LokiMetaSmith/MR1/.jules/memory.md

## Archived: 2026-10-31

- `scripts/render_flythrough.py` renders a three-shot video sequence using PyVista and `simulations/nanopore_electrokinetics.py`: Shot 1 animates a reverse explosion assembly of system and PCB parts; Shot 2 zooms into a 500 µm silicon die, 10x10 µm thinned window, and 100 nm pore; Shot 3 showcases multi-scale pores (100 µm down to 1 nm) with simulated ionic current HUD overlays. Supports `--test` and `--frames` CLI arguments.
- In KiCad 8 footprint S-expression syntax (`.kicad_mod`), `zone_connect` tokens inside pad definitions are invalid syntax. Footprints generated by `scripts/generate_footprint.py` synchronize across `Amplifier/footprints.pretty/`, `Amplifier/footprints/`, and `Interposer/footprints.pretty/`.
- Full suite exports via `scripts/export_all.js` historically fail to generate 2D DXF files (like `Plate_1_Base_DXF.dxf` and `Gasket_Main_DXF.dxf`) due to a known 'Mixing 2D and 3D objects' warning around line 21 in `mr1_nanopore_reader.scad`. This is expected behavior and not a regression.
- In `build123d` (`src/housing.py`), `Housing_Pump_Lid` features a continuous solid top face (without a center pass-through hole) and an attached bottom indexing lip positioned to overlap slightly into the main lid body, producing a single contiguous solid.
- Standardized 4-electrode sensing terminology across the codebase and documentation is: `WS_CIS` (Working Sense), `WE_POS` (Working Electrode Positive), `RE_TRANS` (Reference Electrode Trans), `CE_GNDA` (Counter Electrode Ground), and `GUARD`.
- The canonical project name is 'MR1'. Legacy terms like 'Sentinel', 'Daemon Pore', or 'daemon-pore' have been universally replaced. Specific casing conventions apply: UPPER_CASE or PascalCase contexts use 'MR1', while snake_case, kebab-case, camelCase, and filenames use 'mr1'.
- KiCad BOM and Gerber export tests (e.g., `test_interposer_bom_completeness`, `test_interposer_gerber_exports`) are intentionally skipped and tracked in `TODO.md` pending robust CI support for the `kicad-cli` toolchain.
- In the MR1 system architecture, high-speed ADC U13 (AD40xx) is located on the Cartridge Amplifier board, while dual DAC U9 (MCP4822) resides on the MR1 Main Controller Board.
- Optional topology optimization and simulation extras (`torch`, `dl4to`) are specified in `pyproject.toml` under `[project.optional-dependencies] simulation`.
- `simulations/torque_cap_topology_optimization.py` provides the topology optimization bridge for `Torque_Cap_Outer` flexure arms using build123d CAD design domain definitions and `dl4to`, featuring CLI options and analytical fallback logic when PyTorch/dl4to are omitted.
- `install.sh` checks for PlatformIO in `.venv`, system `PATH`, and via `python -m platformio`, automatically installing `platformio` into `.venv` via `pip` if missing. `scripts/export_manager.py` prioritizes finding `pio` inside `.venv` before checking system `PATH`.
- The `Torque_Cap_Outer` 6 cantilever flexure arms (tongs) use a compliant 1.8 mm PETG living hinge thickness with 2.5 mm root fillets and 1.5 mm radius pawl tips ($R = 38.7\text{ mm}$), tuned to deliver a slip torque limit of $\approx 0.5\text{ N}\cdot\text{m}$ ($F_{\text{clamp}} \approx 33.3\text{ N}$) to compress the 12 pogo pins (~9.6 N total load) and seat the silicone gasket without over-tightening.
- The repository includes a formal verification suite in `tests/test_formal_proofs.py` using `z3-solver` and `hypothesis` to prove SMT theorems and property-based invariants across firmware/protocol logic, physics/analog front-end, geometric/CAD layout, microfluidics, electrokinetics, pump ESTOP safety logic, DAQ stream framing, firmware state machine, and electrical harness pin mapping, integrated directly into `run_tests.py`.
- In `imageio.mimsave`, setting `macro_block_size=1` prevents image width/height padding warnings when exporting 1080p VP9 WebM videos.
- Readout route selection on the MR1 Nanopore Reader uses `PIN_ROUTE_SEL` (GPIO2) to control the `U17` SPDT switch between Route 1 (10 GΩ gain, LMP7721, `ROUTE_SEL` LOW) and Route 2 (100 kΩ gain, OPA2192, `ROUTE_SEL` HIGH). Firmware protocol uses `STATUS_ROUTE2_ACTIVE = (1 << 7)`, commands `SET:ROUTE:<1|2>` and `GET:ROUTE`, `/api/route` HTTP API, and `daq_client.py` auto-adjusts transimpedance gain dynamically from stream telemetry.
- Execute environment setup using `bash ./setup_env.sh` rather than direct execution (`./setup_env.sh`) to prevent permission denied errors.
- The repository includes KiCad projects such as 'Amplifier' and 'MR1'. Auto-generated `.history` directories within these project folders are appropriately ignored via `.gitignore` and must never be tracked as git submodules.
- On the MR1 Interposer, microfluidic Cis flow connects H1 to H2 and Trans flow connects H3 to H4. Standard interposer electrode footprints use `Electrode` and `Electrode_Guard`, while pogo pin target landings default to `PogoPin_Target_Landing_1Pin` (or `PogoPin_Target_Landing_1Pin_Guarded` for High-Z/guard nets).
- In `Interposer/Interposer.kicad_sch` and `Interposer/Interposer.kicad_pcb`, mounting/fluid holes `H1`, `H2`, `H3`, `H4` are defined using `Mechanical:MountingHole` symbols with `Value: FluidHole` and `Footprint: MountingHole:MountingHole_2.1mm`.
- The MR1 Main Controller Board PCB is a 4-layer FR4 design with split ground planes (GNDA and GND on Layer 2) and split power planes (VDDA/VSSA and 3V3/VBUS on Layer 3), driven by an ESP32-S3-MINI-1U microcontroller.
- When calling shape-generating helper functions inside an active `BuildPart` context, encapsulate helper shape construction inside `with BuildPart(mode=Mode.PRIVATE)` to prevent intermediate untapered or raw geometries from automatically merging into the parent context.
- The distributed 2 x 6 pogo pin layout divides pins into Bank B (Cis / High-Z Sensing, Y > 0) and Bank A (Trans / Excitation & Fluid Drain, Y < 0) across X = -18 mm to +18 mm to distribute mechanical spring loads across the 55 mm x 52 mm hexagonal envelope and isolate high-amplitude excitation drive from high-Z sensing nodes.
- In `src/common.py`, `generate_helical_thread` creates trapezoidal helical threads with lead-in/lead-out tapers and radial core shaft overlap (default 0.3mm) to ensure valid, single-solid boolean unions for external and internal threads.
- The Interposer KiCad PCB layout (`Interposer/Interposer.kicad_pcb`) is dynamically generated by `scripts/build_interposer_kicad.py`. Updating interposer board features or 12-pin target layouts requires updating `scripts/build_interposer_kicad.py` and running `python3 scripts/build_interposer_kicad.py --write` to regenerate the PCB file.
- The distributed pogo pin interface maps 12 nets across Cis (Bank B) and Trans (Bank A): P1: `GNDA_SHLD`, P2: `WS_CIS_WIDE` (guarded), P3: `GUARD_WIDE`, P4: `GUARD_CIS_A`, P5: `WS_CIS` (guarded), P6: `GUARD_CIS_B`, P7: `CE_GNDA`, P8: `RE_TRANS`, P9: `>PORE_AMP`, P10: `GNDA`, P11: `WEEP_SENSE`, P12: `GNDA_WEEP`.
- In `build123d`, `Housing_Case_Reader` has a total base case height of 15.0mm (`READER_CASE_H`), cleanly enclosing the 5mm PCB standoffs and USB-C cutout within its internal walls.
- Python test suites in `tests/` (such as `tests/test_geometry.py`) require running with `PYTHONPATH=. python3 tests/test_geometry.py` or `PYTHONPATH=. python3 -m unittest discover tests`.
- `scripts/export_manager.py` supports `--release-tag <version>` (and `make release-gerbers VERSION=<version>`), which generates dynamic PCB deliverables and bundles board Gerbers, BOMs, schematics, and a `SHA256SUMS.txt` manifest into `releases/<version>/` while providing the git tag command for hardware releases.
- A Python virtual environment wrapper script is located at `scripts/run_python.sh`. It auto-detects the repository root and `.venv`, auto-runs `setup_env.sh` if `.venv` is missing, sets `PYTHONPATH` to the repository root, and passes all arguments to the venv Python binary (e.g., `./scripts/run_python.sh scripts/generate_footprint.py --help` or `cd scripts && ./run_python.sh generate_footprint.py --help`).
- In `build123d`, `Housing_Lid_Reader` uses an external helical thread with major diameter 74.5mm, thread depth 4.75mm (`THREAD_DEPTH`), and pitch 8.0mm (`CAP_THREAD_PITCH`). Its mating part `Torque_Cap_Inner` uses a matching 4.75mm thread depth with a 75.5mm internal bore diameter for 3D printing tolerance.
- The project uses `ocp_viewer` as a standalone WebSocket 3D CAD canvas server listening on port 3939. `install.sh --viewer` checks if port 3939 is already active before detaching `python -m ocp_viewer` via `nohup` with stdout/stderr redirected to `/dev/null`, then automatically executes `src/assembly.py` to populate the MR1 assembly model. `src/main.py` supports a `--viewer` (or `--show`) CLI flag to stream exported CAD parts directly to `ocp_viewer`.
- In `src/assembly.py`, `get_tubing_routes()` defines the 5 microfluidic tubing spline routes (`TUBE_PUMP`, `TUBE_FEED`, `TUBE_TRANS_LINE`, `TUBE_WASTE_1`, `TUBE_WASTE_2`), which route through Luer bulkhead panel mount bore holes and hollow housing space into the hexagonal cartridge stack ports without cutting away or overlapping solid CAD model geometries.
- In the build123d python port, `Housing_Lid_Reader` features horizontal side fluid ports at `Z = -13.0`, vertical fluid pass-through holes of `D=13mm`, and explicitly includes `Weep_Duct_Holes` subtracted from the ceiling so the weep drops penetrate into the internal hollow hexagonal cavity.
- The Amplifier board (`Amplifier.kicad_sch`, `Amplifier.kicad_pcb`) uses a single-sided component assembly with all discrete components, ICs, and Mill-Max SMT pogo pins (`P1`–`P12`) placed on `F.Cu` (top layer). Multi-pin header banks are deprecated in favor of 12 discrete 1-pin components (`PogoPin_MillMax_SMT_1Pin` and `PogoPin_MillMax_SMT_1Pin_Guarded`). The interposer mating pad `J_PAD1` uses `PogoPin_Target_Landing_1Pin_Guarded` on `F.Cu` with Pin 1 (`>PORE_AMP`) and Pin 2 (`GUARD`).
- All project files have been changed to be capitalized. When referencing KiCad files (like `.kicad_pcb` or `.kicad_sch`) within scripts or tools, ensure the filenames use capitalized project names (e.g., `Amplifier.kicad_pcb`, `MR1.kicad_pcb`).
- The default 1 Gohm TIA feedback configuration produces a ±2.048 nA dynamic range suited for sub-5 nm apertures; scaling to larger apertures (5-100 nm) or higher currents requires reducing transmembrane bias voltage or adjusting the feedback resistor value (100 Mohm, 10 Mohm, or 1 Mohm).
- When constructing sub-features in `build123d` inside a `with Locations(...)` block, avoid calling `insert()` or `add()` on shapes constructed within that same active context, as active locations will be applied twice. Pre-construct shapes at the origin before placing them with `Locations`.
- Run project tests within the virtual environment using `PYTHONPATH=. /app/.venv/bin/python3 -m unittest discover tests`.
- In `mr1_nanopore_reader.scad`, the STL exports for `Gasket_Mold_Top_STL` and `Gasket_Mold_Bottom_STL` conditionally output the flattened `Nanopore_Wafer_Mold_Right` and `Nanopore_Wafer_Mold_Left` halves when `Use_Nanopore_Wafer_Gasket = true`, replacing the legacy single-piece `Gasket_Mold_3D` export.
- The Reader Module houses the main reader PCB (PCB_Main_Reader) at the bottom of the base case (Housing_Case_Reader) on 5mm standoffs. A single parameterized USB-C port cutout is located on the back wall of the base case at X = USB_OFFSET_X (-15.0). The top lid (Housing_Lid_Reader) is 35mm thick to provide vertical clearance for internal fluid tubing.
- In `Housing_Case_Reader`, the four truncated-sphere feet dimples on the bottom exterior surface are positioned at `(±(BASE_W/2 - FEET_INSET), ±(BASE_L/2 - FEET_INSET))` = `(±42.5mm, ±42.5mm)` at `Z = -READER_CASE_H/2`, matching the corresponding top dimple recesses on `Housing_Pump_Lid` for stacking.
- The 200 nm wide-pore channel (Path 2) utilizes an OPA192/LTC6268 wideband TIA stage ($R_{f2} = 100\text{ k}\Omega$, $C_{f2} = 15\text{ pF}$) connected to Pin 10 (`WS_CIS_WIDE`) with a unity-gain Stage 2 buffer, preventing rail saturation under 200 nA - 2 µA open-pore baseline currents while maintaining ~106 kHz analog bandwidth.
- The project is dedicated to the public domain under the Creative Commons CC0 1.0 Universal license (`CC0-1.0`). Source files (including `.py`, `.scad`, `.cpp`, `.h`, `.sh`) feature the attribution header 'Created by Lawrence R. Kincheloe III / Molecular Reality Corp (2026).' (or specific author attribution such as Jade O'Neill) and 'SPDX-License-Identifier: CC0-1.0'.
- In `build123d` Python scripts, the `add()` function is deprecated; use `insert()` instead for combining parts in a build context.
- Photorealistic PyVista renders use 1080p resolution, SSAA anti-aliasing, a deep studio background (#0E1114 to #1B2026), and multi-point PBR studio lighting (key, fill, rim, overhead lights with 'scenelight').
- The footprint generation script is located at `scripts/generate_footprint.py`. It generates discrete 6-pin/12-pin headers, 4 single-pin modular footprint variants (`PogoPin_MillMax_SMT_1Pin`, `PogoPin_MillMax_SMT_1Pin_Guarded`, `PogoPin_Target_Landing_1Pin`, `PogoPin_Target_Landing_1Pin_Guarded`), and fluid overlay footprints (`Fluid_Overlay_DRILLS`, `Fluid_Overlay_SILKSCREEN_ONLY`). It supports custom per-pin coordinate mapping (`--pin-coords`) and parsing manually placed pin coordinates from KiCad PCB files (`--read-pcb`). Default output location is `Interposer/footprints.pretty/PogoPin_Target_6Pin_Distributed.kicad_mod`.
- `scripts/websocket_bridge.py` (authored by Jade O'Neill / Molecular Reality Corp (2026)) bridges serial or mock DAQ streaming telemetry from `daq_client.DaqClient` to WebSocket clients, converting raw ADC counts into physical current values in picoamperes (pA) and broadcasting binary frame chunks containing an 8-byte uint64 (`<Q`) microsecond timestamp header followed by float32 sample arrays. It batches 16 USB frames by default (1024 samples per message, 4104 bytes total @ ~97.66 Hz, configurable via `--batch-frames`).
- In `src/cartridge.py`, `Rigid_Backing_Anvil` models a 6.0 mm Delrin or Anodized Aluminum 6061-T6 backing anvil to clamp the 2-layer PTFE interposer against point loads from the 12 pogo pins (~0.8 N per pin, ~9.6 N total load) to prevent viscoelastic cold flow (creep).
- When calculating the volume of boolean intersections in build123d Python tests (e.g., `inter = solid.intersect(probe)`), `inter` often returns a `ShapeList`. Handle this by safely summing the volumes of its constituent parts (e.g., `sum(s.volume for s in inter) if inter is not None else 0.0`).
- For a 1/4 inch (6.00 mm - 6.35 mm) spacer stackup, LCSC part # C5221285 (MPN: YTC1P-6030-01) is used as the SMD pogo pin with a 9.0 mm free length, 7.5 mm working height (1.5 mm stroke), and 2.0 mm diameter base for `PogoPin_MillMax_SMT_1Pin` and `PogoPin_MillMax_SMT_1Pin_Guarded` footprints.
- `Amplifier/Amplifier.kicad_pcb` uses a 2-layer 1.5 mm Rogers PTFE (RO3003 / ZYF255DA) core stackup with solder mask clearance exclusions on F.Mask and B.Mask over the LMP7721 guarded region, a B.Cu GNDA keepout zone beneath the input node, and a solid B.Cu GUARD island mirroring the top input node footprint.
- The coax pogo-pin architecture standardizes all pin footprints on Pad 1 = signal (circular or square) and Pad 2 = concentric outer ring (GUARD, GUARD_WIDE, or GNDA), driven by `src/stack_spec.py` as the single source of truth across CAD, KiCad footprints, and verification tests.
- In `Amplifier.kicad_sch`, SMT pogo pin symbols connect Pin 1 (SIG) to signal lines (`WS_CIS_WIDE` on P2, `WS_CIS` on P5) and Pin 2 (GUARD) to active driven guard rings (`GUARD_WIDE` on P2, `GUARD` on P5).
- One-shot dynamic hardware and PCB rebuild is executed via `make rebuild` (`scripts/rebuild_all.py`), which validates `src/stack_spec.py`, generates KiCad footprint libraries, checks CAD solid alignment, exports deliverables, and runs the 160+ test suite. `make rebuild-check` validates CI compliance without modifying files.
- `src/spacers.py` models the 3D-printed adjustable spacer (height >= 3.0 mm) with component cavity relief, solid Polypropylene (PP) 0.030" shim, and Delrin 0.125"/0.270" blocks to fill margins around inverted amplifier components and prevent pogo wicking.
- `scripts/build_amplifier_kicad.py` and `scripts/build_interposer_kicad.py` provide automated `--check` and `--write` sync for discrete coax pin placements on both PCBs, wired directly into `scripts/rebuild_all.py` Step 4.
- `tests/test_legacy_feature_parity.py` was renamed to `tests/test_cad_features.py` (`TestCADFeatureValidation`) to fully disconnect OpenSCAD terminology while preserving build123d feature assertions.
- Capillary rise physics in `simulations/guard_ring_electrostatics.py` verifies that a hydrophobic PP shim (contact angle $\theta \approx 100^\circ$) produces capillary depression ($\cos\theta < 0$), physically arresting saline wicking along pogo pin shafts.
- `scripts/build_amplifier_kicad.py` supports `--sync-spec` to import manual KiCad PCB pin coordinates and guarding directly into `src/stack_spec.py`. `scripts/rebuild_all.py` (and `make rebuild-check`) safely gates manual PCB modifications against accidental overwrites.
- `scripts/back_propagate_pcb.sh` (`make back-propagate-pcb`) provides an automated 5-step pipeline that propagates manual `Amplifier.kicad_pcb` layout changes to `stack_spec.py`, footprint libraries, mating interposer routes, CAD geometry, and test validation.
- BEFORE making ANY change or running modifying scripts/pipelines, ALWAYS verify and capture a git commit or branch of the current repository state (and/or snapshot hardware files with `scripts/backup_hardware.py`). This allows immediate, clean reversal of any error in scripts, commands, or layout adjustments.
- KiCad keepout zones do not dynamically clip or suppress graphical vector lines (`fp_line`, `fp_text`) within placed footprints. To prevent silkscreen over bare copper/guard openings, footprint geometry must be clipped at generation time via Liang-Barsky clipping (`scripts/generate_footprint.py`), non-printed documentation lines/notes placed on `Cmts.User`, and component silkscreen outlines/references over the guard window relocated to `F.Fab` or outside the keepout (`scripts/generate_board_zones.py`).
