LokiMetaSmith/MR1/renders/diff/bare_copper_crop.png

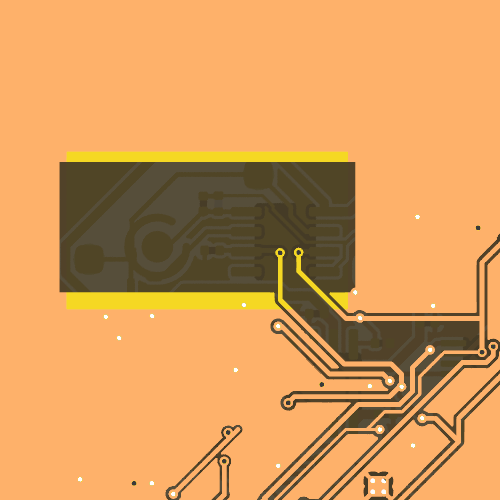
renders/diff/bare_copper_crop.png
