LokiMetaSmith/MR1/renders/diff/bare_copper_top_crop.png

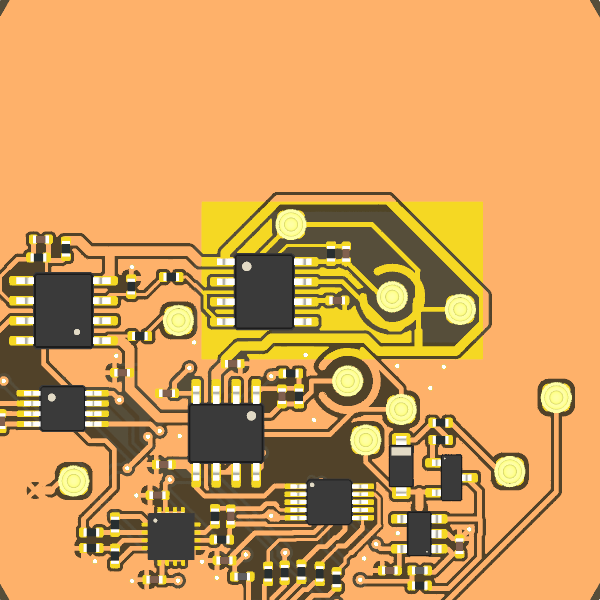
renders/diff/bare_copper_top_crop.png
