LokiMetaSmith/MR1/renders/diff/diff_bottom_highlight.png

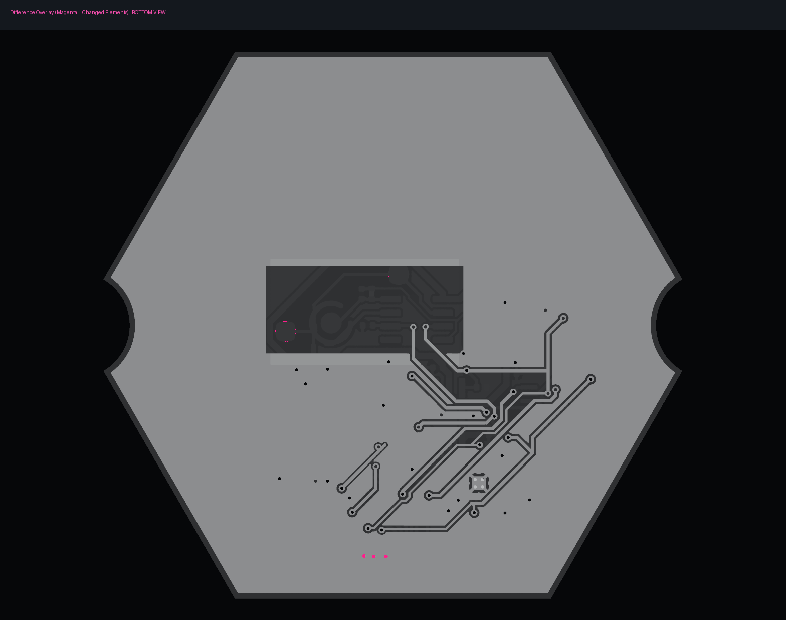
renders/diff/diff_bottom_highlight.png
