LokiMetaSmith/MR1/renders/diff/diff_bottom_side_by_side.png

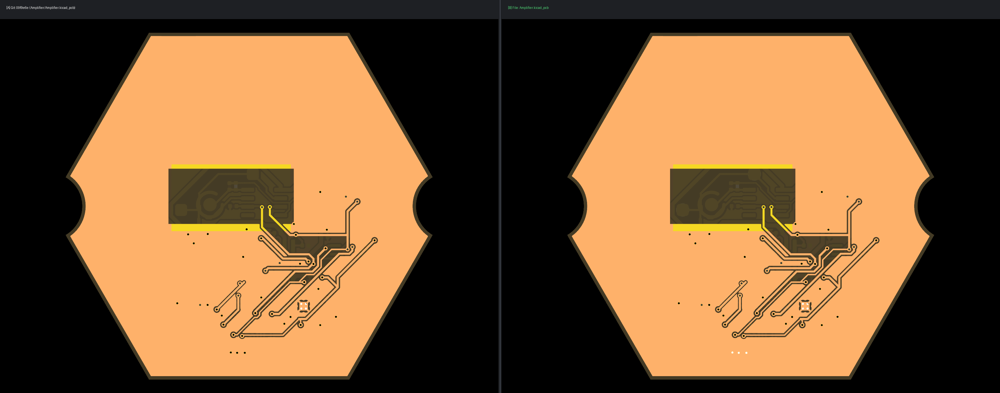
renders/diff/diff_bottom_side_by_side.png
