LokiMetaSmith/MR1/renders/diff/diff_top_highlight.png

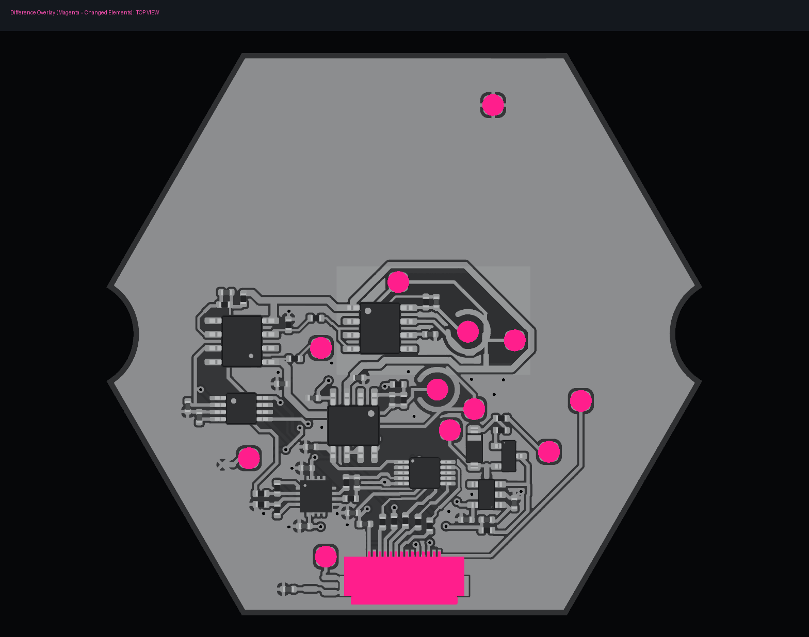
renders/diff/diff_top_highlight.png
