LokiMetaSmith/MR1/renders/diff/diff_top_side_by_side.png

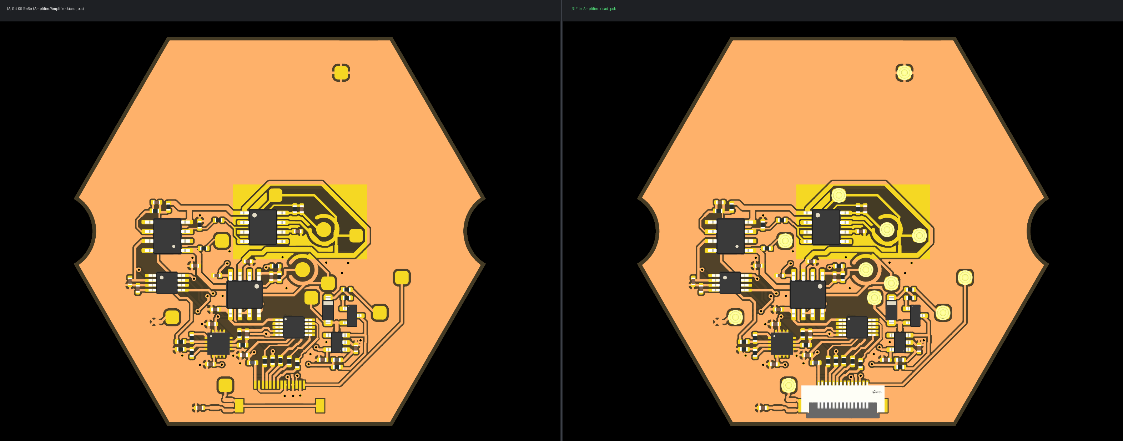
renders/diff/diff_top_side_by_side.png
