LokiMetaSmith/MR1/(list of files, cad)

Other CAD files:
constants.scad
modules/housing_reader.scad
modules/torque_cap.scad
