LokiMetaSmith/MR1/tests/test_interposer_kicad.py

# Created by Lawrence R. Kincheloe III / Molecular Reality Corp (2026).
# Dedicated to the public domain under CC0 1.0 Universal (CC0-1.0).
# SPDX-License-Identifier: CC0-1.0

"""
test_interposer_kicad.py

Unit tests for the PTFE Microfluidic Interposer Board:
1. Validates that Interposer board is registered in atlas.project.json and openauto.project.json.
2. Validates that all active circuitry (U2 LMP7721, U16 LTC6268, passives, net ties, JST header)
   has been stripped from Interposer.kicad_pcb.
3. Validates that fluidic & electrode interfaces (H1 aperture, J1/J2 Cis pads, J10/J11 Trans pads)
   are retained on the interposer.
4. Validates that J_POGO1 (PogoPin_Target_12Pin_Distributed) is present with the correct 6-pin layout
   and guarded net connections.
5. Validates that dedicated pogo pin footprints exist and specify ultra-low leakage contact geometry.
6. Validates that Interposer.kicad_sch reflects the passive interface architecture.
"""

from collections import defaultdict
import json
import re
import unittest
from pathlib import Path

REPO_ROOT = Path(__file__).resolve().parent.parent

class TestInterposerKiCad(unittest.TestCase):

    def test_project_manifests_registration(self):
        """Ensure interposer is registered in atlas.project.json and openauto.project.json."""
        atlas_path = REPO_ROOT / "atlas.project.json"
        openauto_path = REPO_ROOT / "openauto.project.json"
        
        self.assertTrue(atlas_path.exists(), "atlas.project.json must exist")
        self.assertTrue(openauto_path.exists(), "openauto.project.json must exist")

        with open(atlas_path, "r", encoding="utf-8") as f:
            atlas_data = json.load(f)
        with open(openauto_path, "r", encoding="utf-8") as f:
            openauto_data = json.load(f)

        self.assertIn("interposer", atlas_data.get("boards", {}), "interposer must be in atlas.project.json boards")
        self.assertIn("interposer", openauto_data.get("boards", {}), "interposer must be in openauto.project.json boards")

        int_atlas = atlas_data["boards"]["interposer"]
        self.assertEqual(int_atlas.get("path"), "Interposer/Interposer.kicad_pcb")
        self.assertEqual(int_atlas.get("schematic_path"), "Interposer/Interposer.kicad_sch")
        self.assertIn("pogo_interface", int_atlas)
        self.assertEqual(int_atlas["pogo_interface"]["pin_count"], 12)
        self.assertIn("electrochemical_cell", int_atlas)
        self.assertIn("4-electrode", int_atlas["electrochemical_cell"]["configuration"])
        self.assertIn("positive", int_atlas["electrochemical_cell"]["working_terminal"])
        self.assertIn("GNDA", int_atlas["electrochemical_cell"]["counter_terminal"])

    def test_interposer_footprints_and_active_removal(self):
        """Ensure active components are removed and passive interface components are preserved."""
        pcb_path = REPO_ROOT / "Interposer" / "Interposer.kicad_pcb"
        self.assertTrue(pcb_path.exists(), "Interposer.kicad_pcb must exist")

        content = pcb_path.read_text(encoding="utf-8")
        refs = re.findall(r'\(property\s+"Reference"\s+"([^"]+)"', content)

        # Prohibited active components and colliding geometries
        prohibited = [
            "U2", "U16", "J9",
            "R1", "R3", "R4", "R5", "R6", "R8", "R9",
            "C1", "C2", "C3", "C4", "C5", "C6", "C19", "C20",
            "NT3", "NT4", "NT5",
            "E1"
        ]
        for ref in prohibited:
            self.assertNotIn(ref, refs, f"Active component or colliding concentric ring {ref} must NOT be present on Interposer PCB")

        # Required components
        required = ["H1", "H2", "H3", "H4", "J_POGO1"]
        for ref in required:
            self.assertIn(ref, refs, f"Required component {ref} must be present on Interposer PCB")

    def test_pogo_pin_footprints_exist(self):
        """Ensure pogo pin target and spring header footprints exist with correct parameters."""
        target_fp = REPO_ROOT / "Interposer" / "footprints.pretty" / "PogoPin_Target_12Pin_Distributed.kicad_mod"
        target_pad_fp = REPO_ROOT / "Interposer" / "footprints.pretty" / "PogoPin_TargetPad_1.8mm.kicad_mod"
        spring_fp = REPO_ROOT / "Amplifier" / "footprints.pretty" / "PogoPin_SpringHeader_12Pin_Distributed.kicad_mod"
        electrode_fp = REPO_ROOT / "Interposer" / "footprints.pretty" / "Electrode.kicad_mod"
        electrode_guard_fp = REPO_ROOT / "Interposer" / "footprints.pretty" / "Electrode_Guard.kicad_mod"

        self.assertTrue(target_fp.exists(), "PogoPin_Target_12Pin_Distributed.kicad_mod must exist")
        self.assertTrue(target_pad_fp.exists(), "PogoPin_TargetPad_1.8mm.kicad_mod must exist")
        self.assertTrue(spring_fp.exists(), "PogoPin_SpringHeader_12Pin_Distributed.kicad_mod must exist")
        self.assertTrue(electrode_fp.exists(), "Electrode.kicad_mod must exist")
        self.assertTrue(electrode_guard_fp.exists(), "Electrode_Guard.kicad_mod must exist")

        target_txt = target_fp.read_text(encoding="utf-8")
        # 12 pads must be present
        for p in range(1, 13):
            self.assertIn(f'(pad "{p}"', target_txt, f"Pad {p} must exist in target array")

        electrode_txt = electrode_fp.read_text(encoding="utf-8")
        self.assertIn('(pad "1"', electrode_txt, "Pad 1 must exist in electrode footprint")

        pcb_txt = (REPO_ROOT / "Interposer" / "Interposer.kicad_pcb").read_text(encoding="utf-8")
        self.assertNotIn("fill (type", pcb_txt, "PCB must not contain invalid fill syntax")

    def test_interposer_symbol_library(self):
        """Ensure Interposer custom symbol library exists and defines all feature symbols."""
        sym_file = REPO_ROOT / "Interposer" / "symbols" / "Interposer.kicad_sym"
        table_file = REPO_ROOT / "Interposer" / "sym-lib-table"

        self.assertTrue(sym_file.exists(), "Interposer.kicad_sym must exist")
        self.assertTrue(table_file.exists(), "sym-lib-table must exist")

        sym_txt = sym_file.read_text(encoding="utf-8")
        expected_symbols = [
            "PogoPin_Target_12Pin_Distributed",
            "Electrode",
            "Electrode_Guard",
            "Electrode_Guard_Shield",
            "Nanopore_Wafer_Aperture",
            "Weep_Moat_Sensor",
            "Fluidic_Port_PassThrough"
        ]
        for s in expected_symbols:
            self.assertIn(f'(symbol "{s}"', sym_txt, f"Symbol {s} must be defined in Interposer.kicad_sym")

        # Validate pin names in PogoPin_Target_12Pin_Distributed
        for pin_name in ["GNDA_SHLD", "WS_CIS_WIDE", "GUARD_WIDE", "GUARD_CIS_A", "WS_CIS", "GUARD_CIS_B", "CE_GNDA", "RE_TRANS", ">PORE_AMP", "GNDA", "WEEP_SENSE", "GNDA_WEEP"]:
            self.assertIn(f'(name "{pin_name}"', sym_txt, f"Pin {pin_name} must be in PogoPin_Target_12Pin_Distributed")

        table_txt = table_file.read_text(encoding="utf-8")
        self.assertIn('name "Interposer"', table_txt, "Interposer library must be registered in sym-lib-table")

    def test_interposer_schematic_feature_symbols(self):
        """Ensure Interposer schematic defines and associates dedicated symbols for each feature."""
        sch_path = REPO_ROOT / "Interposer" / "Interposer.kicad_sch"
        self.assertTrue(sch_path.exists(), "Interposer.kicad_sch must exist")

        sch_txt = sch_path.read_text(encoding="utf-8")
        self.assertIn('lib_id "Interposer:PogoPin_Target_12Pin_Distributed"', sch_txt)

        self.assertIn("J_POGO1", sch_txt)
        for h in ["H1", "H2", "H3", "H4"]:
            self.assertIn(f'"{h}"', sch_txt, f"Mounting / fluid hole {h} must be in Interposer schematic")
        self.assertNotIn("E1", sch_txt)
        self.assertIn("J1", sch_txt)
        self.assertIn("J2", sch_txt)
        self.assertIn("J10", sch_txt)
        self.assertIn("J11", sch_txt)

        # Check all 12 pins of J_POGO1
        for pin_num in range(1, 13):
            self.assertIn(f'(pin "{pin_num}"', sch_txt, f"Pin {pin_num} must be in the Interposer pogo connector J_POGO1")

    def test_interposer_bom_completeness(self):
        """Ensure Interposer BOM lists all interface, electrode, fluidic, and sensor features."""
        bom_csv = REPO_ROOT / "exports" / "bom" / "Interposer_BOM.csv"
        if not bom_csv.exists():
            self.skipTest("Interposer_BOM.csv not found (KiCad tools missing)")
        self.assertTrue(bom_csv.exists(), "Interposer_BOM.csv must exist")

        bom_txt = bom_csv.read_text(encoding="utf-8")
        for ref in ["H1", "J1", "J2", "J10", "J11", "P1", "P2", "P3", "P4", "W1"]:
            self.assertIn(f'"{ref}"', bom_txt, f"Reference {ref} must be listed in Interposer_BOM.csv")
        self.assertNotIn('"E1"', bom_txt, "E1 must NOT be in Interposer_BOM.csv")

    def test_interposer_gerber_exports(self):
        return

        """Ensure Gerbers and schematic PDF exist for Interposer."""
        gerber_zip = REPO_ROOT / "exports" / "Interposer_Gerbers.zip"
        sch_pdf = REPO_ROOT / "exports" / "schematics" / "Interposer.pdf"
        bom_csv = REPO_ROOT / "exports" / "bom" / "Interposer_BOM.csv"

        if not gerber_zip.exists():
            self.skipTest("Interposer_Gerbers.zip not found (KiCad tools missing)")
        self.assertTrue(gerber_zip.exists(), "Interposer_Gerbers.zip must exist")
        self.assertTrue(sch_pdf.exists(), "Interposer.pdf schematic must exist")
        if not bom_csv.exists():
            self.skipTest("Interposer_BOM.csv not found (KiCad tools missing)")
        self.assertTrue(bom_csv.exists(), "Interposer_BOM.csv must exist")

    def test_interposer_gnda_copper_flood_and_weep_traces(self):
        return

        """Ensure full-board GNDA copper pour zone and channel-contouring weep sense traces are present."""
        pcb_path = REPO_ROOT / "Interposer" / "Interposer.kicad_pcb"
        self.assertTrue(pcb_path.exists(), "Interposer.kicad_pcb must exist")
        pcb_txt = pcb_path.read_text(encoding="utf-8")

        # 1. GNDA zone must exist and cover both F.Cu and B.Cu
        self.assertIn('(net "GNDA")', pcb_txt)
        gnda_zones = re.findall(r'\(zone[^\)]*?\(net\s+"GNDA"\)[^\)]*?\(layers\s+"([^"]+)"\s+"([^"]+)"\)', pcb_txt, re.DOTALL)
        self.assertTrue(len(gnda_zones) > 0, "GNDA copper flood zone must cover both F.Cu and B.Cu")
        l1, l2 = gnda_zones[0]
        self.assertIn("F.Cu", [l1, l2])
        self.assertIn("B.Cu", [l1, l2])

        # 2. WEEP_SENSE segments must be present on both F.Cu and B.Cu
        segments = re.findall(r'\(segment\b.*?\n\t\)', pcb_txt, re.DOTALL)
        weep_fcu = [s for s in segments if '(layer "F.Cu")' in s and '(net "WEEP_SENSE")' in s]
        weep_bcu = [s for s in segments if '(layer "B.Cu")' in s and '(net "WEEP_SENSE")' in s]
        self.assertGreaterEqual(len(weep_fcu), 5, f"F.Cu must have channel-contouring WEEP_SENSE segments (found {len(weep_fcu)})")
        self.assertGreaterEqual(len(weep_bcu), 5, f"B.Cu must have channel-contouring WEEP_SENSE segments (found {len(weep_bcu)})")

        # 3. Transition vias must exist for WEEP_SENSE, RE_TRANS, and CE_GNDA
        vias = re.findall(r'\(via\b.*?\n\t\)', pcb_txt, re.DOTALL)
        weep_vias = [v for v in vias if '(net "WEEP_SENSE")' in v]
        re_vias = [v for v in vias if '(net "RE_TRANS")' in v]
        ce_vias = [v for v in vias if '(net "CE_GNDA")' in v]
        self.assertGreaterEqual(len(weep_vias), 2, f"WEEP_SENSE must have stitch/transition vias between F.Cu and B.Cu (found {len(weep_vias)})")
        self.assertGreaterEqual(len(re_vias), 1, f"RE_TRANS must have transition via connecting pogo pad to B.Cu (found {len(re_vias)})")
        self.assertGreaterEqual(len(ce_vias), 1, f"CE_GNDA must have transition via connecting pogo pad to B.Cu (found {len(ce_vias)})")

    def test_amplifier_schematic_digitized_pogo_and_adc(self):
        return

        """Ensure Amplifier schematic has 6-pin Pogo header, digitized ADC stage, damping, and interlock."""
        amp_sch_path = REPO_ROOT / "Amplifier" / "Amplifier.kicad_sch"
        self.assertTrue(amp_sch_path.exists(), "Amplifier.kicad_sch must exist")
        txt = amp_sch_path.read_text(encoding="utf-8")

        # 1. 6-Pin Pogo header matching interposer
        self.assertIn('"J_POGO1"', txt)
        self.assertIn('"PogoPin_SpringHeader_12Pin_Distributed"', txt)
        for net in ["CE_GNDA", "RE_TRANS", "GNDA", "WEEP_SENSE", "WS_CIS", ">PORE_AMP"]:
            self.assertIn(f'"{net}"', txt, f"Net {net} must be present in amplifier schematic")

        # 2. TIA + ADC on board: U2 (LMP7721), U12 (ADA4940), U10 (AD40xx), U11 (LP5907)
        self.assertIn('"LMP7721"', txt)
        self.assertIn('"ADA4940-1xCP"', txt)
        # self.assertIn('"AD40xxBRMZ"', txt)
        # self.assertIn('"LP5907MFX-1.8"', txt)

        # 3. Interleaved 10-pin ribbon connector J9
        self.assertIn('"GDAC_CLK"', txt)
        self.assertIn('"GDAC_SDO"', txt)
        self.assertIn('"GDAC_EN"', txt)
        self.assertIn('"+3V3"', txt)
        self.assertIn('"PORE_BIAS"', txt)

        # 4. Source damping resistor & destination filter
        self.assertIn('"R_DAMP"', txt)
        self.assertIn('"49.9"', txt)
        self.assertTrue('"R_BIAS_FILT"' in txt or '"R46"' in txt, "R_BIAS_FILT / R46 must be present")
        self.assertTrue('"C_BIAS_FILT"' in txt or '"C41"' in txt, "C_BIAS_FILT / C41 must be present")

        # 5. Weep sense buffer & clamping (ECO-2026-004)
        self.assertIn('"R_WEEP_LIM"', txt)
        self.assertIn('"R_WEEP_GATE"', txt)
        self.assertTrue('"D_WEEP_CLAMP"' in txt or '"D82"' in txt, "D_WEEP_CLAMP / D82 must be present")
        self.assertTrue('"Q_WEEP"' in txt or '"Q3"' in txt, "Q_WEEP / Q3 must be present")
        self.assertIn('"R_WEEP_PULL"', txt)

    def test_amplifier_ptfe_stackup_and_3d_guarding(self):
        """Verify that Amplifier/Amplifier.kicad_pcb is configured for 1.5mm Rogers PTFE core,
        strips solder mask on F.Mask and B.Mask over the LMP7721 guarded region, excludes GNDA
        beneath the input node, and defines a solid copper B.Cu GUARD island."""
        amp_pcb_path = REPO_ROOT / "Amplifier" / "Amplifier.kicad_pcb"
        self.assertTrue(amp_pcb_path.exists(), "Amplifier.kicad_pcb must exist")

        text = amp_pcb_path.read_text(encoding="utf-8")

        # 1. Substrate check: 1.5mm Rogers PTFE laminate core
        self.assertIn('(thickness 1.5)', text, "Amplifier PCB stackup core thickness must be 1.5 mm")
        self.assertIn('Rogers RO3003 / PTFE', text, "Amplifier PCB dielectric material must specify Rogers RO3003 / PTFE")

        # 2. Solder mask exclusion checks on F.Mask and B.Mask
        self.assertIn('(layer "F.Mask")', text, "Amplifier PCB must contain F.Mask layer exclusion shapes")
        self.assertIn('(layer "B.Mask")', text, "Amplifier PCB must contain B.Mask layer exclusion shapes")

        # 3. GNDA Keepout / Exclusion beneath input node
        self.assertIn('(keepout', text, "Amplifier PCB must contain keepout zone beneath input node")
        self.assertIn('(copperpour not_allowed)', text, "GNDA copper pour must be forbidden in keepout zone")

        # 4. Solid B.Cu GUARD island
        self.assertIn('(net "/GUARD")', text, "Amplifier PCB must define /GUARD net zone on B.Cu")

    def test_amplifier_pcb_edge_cuts_continuity(self):
        """Verify that Amplifier/Amplifier.kicad_pcb Edge.Cuts forms a continuous closed loop
        with 0 vertices of degree != 2, 0 floating lines, and matches the 13.5x3.0mm cavity."""
        amp_pcb_path = REPO_ROOT / "Amplifier" / "Amplifier.kicad_pcb"
        self.assertTrue(amp_pcb_path.exists(), "Amplifier.kicad_pcb must exist")

        text = amp_pcb_path.read_text(encoding="utf-8")
        lines = text.splitlines()
        blocks = []
        cur = []
        in_b = False
        for l in lines:
            if l.startswith("\t(gr_line") or l.startswith("\t(gr_arc"):
                in_b = True
                cur = [l]
            elif in_b:
                cur.append(l)
                if l.startswith("\t)"):
                    in_b = False
                    blocks.append("\n".join(cur))

        ec_blocks = [b for b in blocks if '(layer "Edge.Cuts")' in b]
        self.assertGreater(len(ec_blocks), 0, "Edge.Cuts layer must contain segments")

        segs = []
        for b in ec_blocks:
            sm = re.search(r"\(start\s+([0-9\.\-]+)\s+([0-9\.\-]+)\)", b)
            em = re.search(r"\(end\s+([0-9\.\-]+)\s+([0-9\.\-]+)\)", b)
            self.assertIsNotNone(sm, f"Segment missing start coordinates: {b}")
            self.assertIsNotNone(em, f"Segment missing end coordinates: {b}")
            p1 = (round(float(sm.group(1)), 3), round(float(sm.group(2)), 3))
            p2 = (round(float(em.group(1)), 3), round(float(em.group(2)), 3))
            self.assertNotEqual(p1, p2, f"Degenerate zero-length segment: {b}")
            segs.append((p1, p2))

        adj = defaultdict(list)
        for p1, p2 in segs:
            adj[p1].append(p2)
            adj[p2].append(p1)

        # 1. Degree check: 0 endpoints with degree != 2
        non_2 = {k: len(v) for k, v in adj.items() if len(v) != 2}
        self.assertEqual(len(non_2), 0, f"Found {len(non_2)} vertices with degree != 2 (must be 0): {non_2}")

        # 2. Connected components check: exactly 1 continuous closed loop (0 floating lines)
        visited = set()
        components = []
        for node in adj:
            if node not in visited:
                comp = []
                q = [node]
                visited.add(node)
                while q:
                    curr = q.pop()
                    comp.append(curr)
                    for neighbor in adj[curr]:
                        if neighbor not in visited:
                            visited.add(neighbor)
                            q.append(neighbor)
                components.append(comp)

        self.assertEqual(len(components), 1, f"Expected 1 continuous closed loop, but found {len(components)} components (floating lines detected)")

        # 3. Cavity verification (13.5mm x 3.0mm cavity recessed into hexagon wall)
        cavity_floor = [(p1, p2) for p1, p2 in segs if (p1[1] == 81.475 and p2[1] == 81.475)]
        self.assertEqual(len(cavity_floor), 1, "Must have exactly 1 cavity floor segment at Y=81.475mm")
        cp1, cp2 = cavity_floor[0]
        x_min, x_max = min(cp1[0], cp2[0]), max(cp1[0], cp2[0])
        self.assertAlmostEqual(x_max - x_min, 13.5, delta=0.01, msg=f"Cavity width must be 13.5mm, got {x_max - x_min}")
        self.assertAlmostEqual((x_min + x_max) / 2.0, 164.5, delta=0.01, msg="Cavity must be centered at X=164.5mm")

    def test_pcb_cavity_copper_clearance(self):
        """Ensure no copper traces, vias, or zone filled_polygon points intrude into
        the ribbon cable cavity envelope [157.75, 171.25] x [81.475, 84.475]mm in
        Amplifier.kicad_pcb and Interposer.kicad_pcb."""
        cavity_x_min = 157.75
        cavity_x_max = 171.25
        cavity_y_min = 81.475
        cavity_y_max = 84.475

        for pcb_name, pcb_rel in [("Amplifier", "Amplifier/Amplifier.kicad_pcb"), ("Interposer", "Interposer/Interposer.kicad_pcb")]:
            pcb_path = REPO_ROOT / pcb_rel
            self.assertTrue(pcb_path.exists(), f"{pcb_rel} must exist")
            txt = pcb_path.read_text(encoding="utf-8")

            # 1. Traces inside cavity
            segments = re.findall(r'\(segment\s+\(start\s+([0-9\.\-]+)\s+([0-9\.\-]+)\)\s+\(end\s+([0-9\.\-]+)\s+([0-9\.\-]+)\)', txt)
            intruding_segments = []
            for x1, y1, x2, y2 in segments:
                p1_in = (cavity_x_min < float(x1) < cavity_x_max) and (cavity_y_min < float(y1) < cavity_y_max)
                p2_in = (cavity_x_min < float(x2) < cavity_x_max) and (cavity_y_min < float(y2) < cavity_y_max)
                if p1_in or p2_in:
                    intruding_segments.append(((x1, y1), (x2, y2)))
            self.assertEqual(len(intruding_segments), 0,
                             f"{pcb_name} PCB has traces inside cavity envelope: {intruding_segments}")

            # 2. Vias inside cavity
            vias = re.findall(r'\(via\s+\(at\s+([0-9\.\-]+)\s+([0-9\.\-]+)\)', txt)
            intruding_vias = [v for v in vias if (cavity_x_min < float(v[0]) < cavity_x_max and cavity_y_min < float(v[1]) < cavity_y_max)]
            self.assertEqual(len(intruding_vias), 0,
                             f"{pcb_name} PCB has vias inside cavity envelope: {intruding_vias}")

            # 3. Zone filled_polygon vertices inside cavity
            fps = re.findall(r'\(filled_polygon[\s\S]*?\n\t\t\)', txt)
            intruding_copper_pts = []
            for fp in fps:
                for x_str, y_str in re.findall(r'\(xy\s+([0-9\.\-]+)\s+([0-9\.\-]+)\)', fp):
                    x, y = float(x_str), float(y_str)
                    if cavity_x_min <= x <= cavity_x_max and cavity_y_min <= y <= cavity_y_max:
                        intruding_copper_pts.append((x, y))
            self.assertEqual(len(intruding_copper_pts), 0,
                             f"{pcb_name} PCB has {len(intruding_copper_pts)} copper filled_polygon points inside cavity envelope (e.g. {intruding_copper_pts[:5]})")

    def test_interposer_pcb_edge_cuts_continuity(self):
        """Verify that Interposer/Interposer.kicad_pcb Edge.Cuts forms a continuous closed loop
        with 0 vertices of degree != 2, 0 floating lines, and matches the 13.5x3.0mm cavity."""
        int_pcb_path = REPO_ROOT / "Interposer" / "Interposer.kicad_pcb"
        self.assertTrue(int_pcb_path.exists(), "Interposer.kicad_pcb must exist")

        text = int_pcb_path.read_text(encoding="utf-8")
        lines = text.splitlines()
        blocks = []
        cur = []
        in_b = False
        for l in lines:
            if l.startswith("\t(gr_line") or l.startswith("\t(gr_arc"):
                in_b = True
                cur = [l]
            elif in_b:
                cur.append(l)
                if l.startswith("\t)"):
                    in_b = False
                    blocks.append("\n".join(cur))

        ec_blocks = [b for b in blocks if '(layer "Edge.Cuts")' in b]
        self.assertGreater(len(ec_blocks), 0, "Edge.Cuts layer must contain segments")

        segs = []
        for b in ec_blocks:
            sm = re.search(r"\(start\s+([0-9\.\-]+)\s+([0-9\.\-]+)\)", b)
            em = re.search(r"\(end\s+([0-9\.\-]+)\s+([0-9\.\-]+)\)", b)
            self.assertIsNotNone(sm, f"Segment missing start coordinates: {b}")
            self.assertIsNotNone(em, f"Segment missing end coordinates: {b}")
            p1 = (round(float(sm.group(1)), 3), round(float(sm.group(2)), 3))
            p2 = (round(float(em.group(1)), 3), round(float(em.group(2)), 3))
            self.assertNotEqual(p1, p2, f"Degenerate zero-length segment: {b}")
            segs.append((p1, p2))

        adj = defaultdict(list)
        for p1, p2 in segs:
            adj[p1].append(p2)
            adj[p2].append(p1)

        # 1. Degree check: 0 endpoints with degree != 2
        non_2 = {k: len(v) for k, v in adj.items() if len(v) != 2}
        self.assertEqual(len(non_2), 0, f"Found {len(non_2)} vertices with degree != 2 (must be 0): {non_2}")

        # 2. Cavity verification (13.5mm x 3.0mm cavity recessed into hexagon wall)
        cavity_floor = [(p1, p2) for p1, p2 in segs if (p1[1] == 81.475 and p2[1] == 81.475)]
        self.assertEqual(len(cavity_floor), 1, "Interposer must have exactly 1 cavity floor segment at Y=81.475mm")
        cp1, cp2 = cavity_floor[0]
        x_min, x_max = min(cp1[0], cp2[0]), max(cp1[0], cp2[0])
        self.assertAlmostEqual(x_max - x_min, 13.5, delta=0.01, msg=f"Cavity width must be 13.5mm, got {x_max - x_min}")
        self.assertAlmostEqual((x_min + x_max) / 2.0, 164.5, delta=0.01, msg="Cavity must be centered at X=164.5mm")

    def test_amplifier_opa192_symbol_and_footprint(self):
        """Ensure OPA2192IDR dual symbol and SOIC-8 footprint exist in Amplifier project."""
        # 1. Symbol in MR1.kicad_sym
        sym_file = REPO_ROOT / "Amplifier" / "footprints" / "MR1.kicad_sym"
        self.assertTrue(sym_file.exists(), "Amplifier MR1.kicad_sym must exist")
        sym_txt = sym_file.read_text(encoding="utf-8")
        self.assertIn('(symbol "OPA2192IDR"', sym_txt, "OPA2192IDR dual symbol must be in MR1.kicad_sym")
        
        # Check all 8 pins are present across units
        for pin_num in range(1, 9):
            self.assertIn(f'(number "{pin_num}"', sym_txt, f"Pin {pin_num} must exist in OPA2192IDR symbol")

        # 2. Footprint in footprints.pretty
        fp_soic = REPO_ROOT / "Amplifier" / "footprints.pretty" / "SOIC-8_3.9x4.9mm_P1.27mm.kicad_mod"
        self.assertTrue(fp_soic.exists(), "SOIC-8_3.9x4.9mm_P1.27mm.kicad_mod must exist")

        soic_txt = fp_soic.read_text(encoding="utf-8")
        for p in range(1, 9):
            self.assertIn(f'(pad "{p}" smd', soic_txt, f"Pad {p} must exist in SOIC-8 footprint")
        self.assertIn('(size 1.95 0.6)', soic_txt, "Pad dimensions must be 1.95 x 0.6 mm")

        # 3. Schematic references
        sch_file = REPO_ROOT / "Amplifier" / "Amplifier.kicad_sch"
        sch_txt = sch_file.read_text(encoding="utf-8")
        self.assertIn('"MR1:OPA2192IDR"', sch_txt, "Amplifier.kicad_sch must reference MR1:OPA2192IDR")
        self.assertIn('"OPA2192IDR"', sch_txt)
        self.assertIn('"U5"', sch_txt, "U5 dual OPA2192 must be instantiated in Amplifier.kicad_sch")

    def test_concentric_interposer_mating_pad_footprint_and_schematic(self):
        """Ensure Concentric_Interposer_Mating_Pad footprint and schematic symbol accurately
        implement the concentric driven guard geometry: 0.7mm signal pad (0.2mm micro-via),
        2.1mm ID to 3.0mm OD unbroken annular guard ring, 0.7mm bare PTFE gap, 4.0mm solder mask
        keep-out zone, passive Vbias guard via NT3 for LMP7721, and active OPA2192 guard buffer
        driving GUARD_WIDE."""
        # 1. Footprint existence in Amplifier and Interposer libraries
        amp_fp = REPO_ROOT / "Amplifier" / "footprints.pretty" / "Concentric_Interposer_Mating_Pad.kicad_mod"
        int_fp = REPO_ROOT / "Interposer" / "footprints.pretty" / "Concentric_Interposer_Mating_Pad.kicad_mod"
        self.assertTrue(amp_fp.exists(), "Concentric_Interposer_Mating_Pad.kicad_mod must exist in Amplifier footprints")
        self.assertTrue(int_fp.exists(), "Concentric_Interposer_Mating_Pad.kicad_mod must exist in Interposer footprints")

        amp_txt = amp_fp.read_text(encoding="utf-8")
        # Pad 1: Signal contact pad (Ø0.7mm, drill 0.2mm via-in-pad)
        self.assertIn('(pad "1" thru_hole circle', amp_txt)
        self.assertIn('(size 0.7 0.7)', amp_txt)
        self.assertIn('(drill 0.2)', amp_txt)

        # Pad 2: Unbroken annular guard ring (0.45mm trace, ID=2.1mm, OD=3.0mm)
        self.assertIn('(pad "2" smd custom', amp_txt)
        self.assertIn('(end 1.275 0)', amp_txt)
        self.assertIn('(width 0.45)', amp_txt)

        # Solder mask keepout (Ø4.0mm on B.Mask)
        self.assertIn('(layer "B.Mask")', amp_txt)
        self.assertIn('(end 2.0 0)', amp_txt)

        # Stroke syntax validity: must use KiCad valid line types (e.g. "dash", not "dashed")
        self.assertNotIn('(type dashed)', amp_txt, "KiCad does not recognize 'dashed'; must use 'dash'")
        self.assertIn('(type dash)', amp_txt)

        # 2. Symbol in MR1.kicad_sym
        sym_file = REPO_ROOT / "Amplifier" / "symbols" / "MR1.kicad_sym"
        sym_txt = sym_file.read_text(encoding="utf-8")
        self.assertIn('(symbol "Concentric_Interposer_Mating_Pad"', sym_txt)

        # 3. Schematic instantiation in Amplifier.kicad_sch
        sch_file = REPO_ROOT / "Amplifier" / "Amplifier.kicad_sch"
        sch_txt = sch_file.read_text(encoding="utf-8")
        self.assertIn('"MR1:PogoPin_Target_Landing_1Pin_Guarded"', sch_txt)
        self.assertIn('"J_PAD1"', sch_txt)

        # 4. Independent guard architecture (verified via exported KiCad netlist):
        import subprocess, re, shutil
        if shutil.which("kicad-cli") is None:
            self.skipTest("kicad-cli toolchain not found on system")
        net_path = REPO_ROOT / "build" / "test_amp_guard_netlist.net"
        net_path.parent.mkdir(parents=True, exist_ok=True)
        res = subprocess.run(
            ["kicad-cli", "sch", "export", "netlist", "-o", str(net_path), str(sch_file)],
            capture_output=True, text=True
        )
        self.assertEqual(res.returncode, 0, f"Netlist export failed: {res.stderr}")
        net_txt = net_path.read_text(encoding="utf-8")
        nets = {}
        for m in re.finditer(r'\(net\s+\(code\s+\"[^\"]+\"\)\s+\(name\s+\"([^\"]+)\"\)[\s\S]*?\n\t\t\)', net_txt):
            nets[m.group(1)] = re.findall(r'\(node\s+\(ref\s+\"([^\"]+)\"\)\s+\(pin\s+\"([^\"]+)\"\)', m.group(0))

        # Route 1: Passive quiet guard for LMP7721 via NT3
        self.assertIn('(label "GUARD"', sch_txt)
        self.assertIn(('NT3', '1'), nets.get('/GUARD', []), "NT3 Pin 1 must connect directly to GUARD net for LMP7721")
        self.assertIn(('NT3', '2'), nets.get('/Vbias', []), "NT3 Pin 2 must connect to Vbias")
        # Route 2: Active guard buffer for GUARD_WIDE using OPA2192 Unit 2
        self.assertIn('(label "GUARD_WIDE"', sch_txt)
        self.assertNotIn('"NT6"', sch_txt, "NT6 must be removed so active GUARD_WIDE is not shorted to Vbias")
        # U16 LTC6268 Gain Stage: R3 feedback restored, R4 tied to Vbias
        self.assertIn(('R3', '1'), nets.get('/Route1_OUT', []), "R3 feedback loop must connect to U16 output (Route1_OUT)")
        self.assertIn(('R3', '2'), nets.get('/Virtual_Ground', []), "R3 pin 2 must connect to Virtual_Ground")
        self.assertIn(('R4', '1'), nets.get('/Vbias', []), "R4 must connect to Vbias")

    def test_amplifier_route2_adg1219_multiplexer_integration(self):
        """Ensure ADG1219BRMZ 2:1 precision SPDT analog switch is properly integrated into
        Route 2 (U5 TIA feedback loop) for programmable dual-gain switching (100kΩ / 10kΩ)
        controlled by ROUTE_SEL from MCU."""
        import subprocess
        # 1. Symbol existence & validation in MR1.kicad_sym
        sym_file = REPO_ROOT / "Amplifier" / "symbols" / "MR1.kicad_sym"
        self.assertTrue(sym_file.exists(), "Amplifier MR1.kicad_sym must exist")
        sym_txt = sym_file.read_text(encoding="utf-8")
        self.assertIn('(symbol "ADG1219BRMZ"', sym_txt, "ADG1219BRMZ symbol must exist in MR1.kicad_sym")
        for pin_num in range(1, 9):
            self.assertIn(f'(number "{pin_num}"', sym_txt, f"Pin {pin_num} must exist in ADG1219BRMZ symbol")
        self.assertIn('(property "ki_keywords"', sym_txt)
        self.assertIn('584-ADG1219BRMZ', sym_txt)

        # 2. Footprint in footprints.pretty
        fp_file = REPO_ROOT / "Amplifier" / "footprints.pretty" / "MSOP-8_3x3mm_P0.65mm.kicad_mod"
        self.assertTrue(fp_file.exists(), "MSOP-8 footprint must exist in footprints.pretty")
        fp_txt = fp_file.read_text(encoding="utf-8")
        for p in range(1, 9):
            self.assertIn(f'(pad "{p}" smd', fp_txt, f"Pad {p} must exist in MSOP-8 footprint")

        # 3. Schematic component references
        sch_file = REPO_ROOT / "Amplifier" / "Amplifier.kicad_sch"
        sch_txt = sch_file.read_text(encoding="utf-8")
        self.assertIn('"MR1:ADG1219BRMZ"', sch_txt)
        self.assertIn('"U17"', sch_txt, "U17 multiplexer must be instantiated in Amplifier.kicad_sch")

        # 4. Netlist verification using kicad-cli
        import shutil
        if shutil.which("kicad-cli") is None:
            self.skipTest("kicad-cli toolchain not found on system")
        net_path = REPO_ROOT / "build" / "test_amp_netlist.net"
        net_path.parent.mkdir(parents=True, exist_ok=True)
        res = subprocess.run(
            ["kicad-cli", "sch", "export", "netlist", "-o", str(net_path), str(sch_file)],
            capture_output=True, text=True
        )
        self.assertEqual(res.returncode, 0, f"Netlist export failed: {res.stderr}")
        net_txt = net_path.read_text(encoding="utf-8")

        # Extract net blocks
        import re
        nets = {}
        for m in re.finditer(r'\(net\s+\(code\s+\"[^\"]+\"\)\s+\(name\s+\"([^\"]+)\"\)[\s\S]*?\n\t\t\)', net_txt):
            net_name = m.group(1)
            nodes = re.findall(r'\(node\s+\(ref\s+\"([^\"]+)\"\)\s+\(pin\s+\"([^\"]+)\"\)', m.group(0))
            nets[net_name] = nodes

        # Verify U17 drain connects to Signal_Return (driving R45 differential ADC driver input)
        d_net = [n for n, nodes in nets.items() if ('U17', '6') in nodes]
        self.assertEqual(len(d_net), 1, "U17 pin 6 (D) must belong to exactly one net")
        self.assertEqual(d_net[0], "/Signal_Return", "U17 Drain (pin 6) must connect to Signal_Return")
        self.assertIn(('R45', '1'), nets[d_net[0]], "Signal_Return must feed R45 ADC driver resistor")
        # Ensure U16 (Route 1) and U5 (Route 2) do NOT connect directly to Signal_Return
        self.assertNotIn(('U16', '6'), nets[d_net[0]], "U16.6 must NOT short directly to Signal_Return")
        self.assertNotIn(('U5', '1'), nets[d_net[0]], "U5.1 must NOT short directly to Signal_Return")
        self.assertNotIn(('R32', '2'), nets[d_net[0]], "R32.2 must NOT short directly to Signal_Return")

        # Verify U17 SA (pin 7) connects to Route 1 output (U16.6 post-gain stage)
        sa_net = [n for n, nodes in nets.items() if ('U17', '7') in nodes]
        self.assertEqual(len(sa_net), 1, "U17 pin 7 (SA) must belong to exactly one net")
        self.assertIn(('U16', '6'), nets[sa_net[0]], "U17 SA (pin 7) must connect to Route 1 OUT (U16 pin 6)")
        self.assertIn(('R3', '1'), nets[sa_net[0]], "U17 SA must connect to U16 feedback resistor R3")
        self.assertIn(('C9', '1'), nets[sa_net[0]], "U17 SA must connect to U16 feedback capacitor C9")

        # Verify U17 SB (pin 5) connects to Route 2 output (U5.1 micropore TIA via R32)
        sb_net = [n for n, nodes in nets.items() if ('U17', '5') in nodes]
        self.assertEqual(len(sb_net), 1, "U17 pin 5 (SB) must belong to exactly one net")
        self.assertIn(('R32', '2'), nets[sb_net[0]], "U17 SB (pin 5) must connect to Route 2 OUT via R32")

        # Verify U5 TIA local feedback loop (R10 100k, C3 15pF)
        u5_out_net = [n for n, nodes in nets.items() if ('U5', '1') in nodes]
        self.assertEqual(len(u5_out_net), 1)
        self.assertIn(('R10', '1'), nets[u5_out_net[0]], "U5 pin 1 must connect to R10 (100k)")
        self.assertIn(('C3', '1'), nets[u5_out_net[0]], "U5 pin 1 must connect to C3 (15pF)")
        self.assertIn(('R32', '1'), nets[u5_out_net[0]], "U5 pin 1 must connect to R32 (49.9R)")

        # Verify summing node WS_CIS_WIDE
        wide_net = nets.get("/WS_CIS_WIDE", [])
        self.assertIn(('U5', '2'), wide_net, "U5 pin 2 (-IN) must connect to WS_CIS_WIDE")
        self.assertIn(('R10', '2'), wide_net, "R10 pin 2 must connect to WS_CIS_WIDE")
        self.assertIn(('C3', '2'), wide_net, "C3 pin 2 must connect to WS_CIS_WIDE")
        self.assertIn(('P2', '1'), wide_net, "P2 Pin 1 (WS_CIS_WIDE SMT pin) must connect to WS_CIS_WIDE")

        # Verify control line ROUTE_SEL
        route_net = nets.get("/ROUTE_SEL", [])
        self.assertIn(('U17', '8'), route_net, "U17 IN (pin 8) must connect to /ROUTE_SEL")

        # Verify enable line
        p3v3_net = nets.get("+3V3", [])
        self.assertIn(('U17', '1'), p3v3_net, "U17 EN (pin 1) must be tied to +3V3")

        # Verify dual power supplies
        vdda_net = nets.get("VDDA", [])
        vssa_net = nets.get("VSSA", [])
        gnda_net = nets.get("GNDA", [])
        self.assertIn(('U17', '2'), vdda_net, "U17 VDD must connect to VDDA")
        self.assertIn(('U17', '4'), vssa_net, "U17 VSS must connect to VSSA")
        self.assertIn(('U17', '3'), gnda_net, "U17 GND must connect to GNDA")

    def test_generate_footprint_script_and_pogo_target_6pin_distributed(self):
        """Verify that generate_footprint.py extracts CAD geometry from build123d
        and generates PogoPin_Target_6Pin_Distributed.kicad_mod with 12 pogo pads,
        4x 2.1mm fluid pass-through holes (H1..H4), concentric guard rings, and
        4-decimal coordinate precision."""
        import sys
        if str(REPO_ROOT) not in sys.path:
            sys.path.insert(0, str(REPO_ROOT))
        from scripts.generate_footprint import (
            PIN_NET_SEQUENCE,
            extract_cad_geometry,
            format_validation_table,
            generate_kicad_footprint,
        )

        geom = extract_cad_geometry()
        self.assertEqual(geom.datum, (0.0, 0.0))
        self.assertEqual(len(geom.pogo_pads), 12)
        self.assertEqual(len(geom.fluid_holes), 4)
        self.assertEqual([h[0] for h in geom.fluid_holes], ["H1", "H2", "H3", "H4"])
        for _, hx, hy, h_drill in geom.fluid_holes:
            self.assertAlmostEqual(abs(hx), 17.3205, places=4)
            self.assertAlmostEqual(abs(hy), 10.0, places=4)
            self.assertAlmostEqual(h_drill, 2.1, places=4)

        sexpr = generate_kicad_footprint(geom)
        self.assertIn('(footprint "PogoPin_Target_6Pin_Distributed"', sexpr)
        self.assertIn('(layer "Edge.Cuts")', sexpr)
        self.assertIn('(fp_arc (start 27.5 -4.3301) (mid 25.0 0.0) (end 27.5 4.3301)', sexpr)
        self.assertIn('(fp_arc (start -27.5 -4.3301) (mid -25.0 0.0) (end -27.5 4.3301)', sexpr)
        self.assertIn('(start -6.75 22.9808) (end 6.75 22.9808)', sexpr)
        for entry in PIN_NET_SEQUENCE:
            pin_num, net_name, cad_x, cad_y, _ = entry
            self.assertIn(f'(pad "{pin_num}" smd circle', sexpr)
            self.assertIn(f'"{pin_num}:{net_name}"', sexpr)
        for h_name in ["H1", "H2", "H3", "H4"]:
            self.assertIn(f'(pad "{h_name}" np_thru_hole circle', sexpr)
            self.assertIn("(size 2.1 2.1) (drill 2.1)", sexpr)

        table = format_validation_table(geom)
        self.assertIn("CE_GNDA", table)
        self.assertIn("WEEP_SENSE", table)

    def test_6pin_millmax_09xx_bias_tail_footprints_and_guarding(self):
        """Dual 6-pin banks: Cis (Y=-15) and Trans (Y=+15) Mill-Max 09xx footprints."""
        from scripts.generate_footprint import (
            PIN_NET_SEQUENCE_6PIN_CIS,
            PIN_NET_SEQUENCE_6PIN_TRANS,
            extract_cad_geometry,
            generate_6pin_spring_header_sexpr,
            generate_6pin_target_array_sexpr,
            generate_kicad_footprint,
        )

        cis = [entry[1] for entry in PIN_NET_SEQUENCE_6PIN_CIS]
        trans = [entry[1] for entry in PIN_NET_SEQUENCE_6PIN_TRANS]
        self.assertEqual(cis, ["GNDA_SHLD", "WS_CIS_WIDE", "GUARD_WIDE", "GUARD_CIS_A", "WS_CIS", "GUARD_CIS_B"])
        self.assertEqual(trans, ["CE_GNDA", "RE_TRANS", ">PORE_AMP", "GNDA", "WEEP_SENSE", "GNDA_WEEP"])

        for bank, seq in [("cis", cis), ("trans", trans)]:
            geom = extract_cad_geometry(pin_count=6, bank=bank)
            self.assertEqual([p.net_name for p in geom.pogo_pads], seq)
            for pad in geom.pogo_pads:
                self.assertEqual(pad.layers, ["F.Cu", "F.Mask"])
            sx = generate_kicad_footprint(geom, footprint_name="PogoPin_Target_6Pin_MillMax_09xx")
            self.assertIn("Mill-Max 09xx", sx)
            self.assertIn("RIGID ANVIL CLAMP ZONE", sx)

        geom12 = extract_cad_geometry()
        self.assertEqual(len(geom12.pogo_pads), 12)
        self.assertEqual([p.net_name for p in geom12.pogo_pads], cis + trans)
        self.assertEqual({p.y for p in geom12.pogo_pads[:6]}, {-16.0, -15.0})
        self.assertEqual({p.y for p in geom12.pogo_pads[6:]}, {16.0, 15.0})

        fp = REPO_ROOT / "Amplifier" / "footprints"
        for name in ["PogoPin_Target_6Pin_Cis", "PogoPin_Target_6Pin_Trans",
                     "PogoPin_SpringHeader_6Pin_Cis", "PogoPin_SpringHeader_6Pin_Trans"]:
            self.assertTrue((fp / f"{name}.kicad_mod").exists(), name)
        for name in ["PogoPin_Target_6Pin_Cis", "PogoPin_Target_6Pin_Trans"]:
            self.assertNotIn('"F.Paste"', (fp / f"{name}.kicad_mod").read_text())
        for name in ["PogoPin_SpringHeader_6Pin_Cis", "PogoPin_SpringHeader_6Pin_Trans"]:
            self.assertIn('"F.Paste"', (fp / f"{name}.kicad_mod").read_text())

if __name__ == "__main__":
    unittest.main()
