LokiMetaSmith/MR1/(commit log)

2026-01-08 Update Cartridge to Hexagonal Single-Sided PCB stack
    - Updated `PCB_Rigid_Active` to be a full 60mm Hexagonal Plate ("Single-Sided PCBA") with 4 bottom-side electrodes and Top Fluid pass-throughs.
    - Removed `Carrier_Frame_Hex` entirely; the PCB now stacks directly between gaskets.
    - Modified `Gasket_Low_Dead_Volume` to split the bottom layer into Center (Chip) and Trans Loop zones.
    - Implemented "U-Turn" Trans fluid routing in `Plate_1_Base_Hex_3D`:
    - Blind Vias (no bottom puncture) connect Inlet -> Channel -> Up to Pads -> Down to Center.
    - Implemented "Sloped Roof" (Rising Floor) channel geometry under the chip to prevent bubble trapping.
    - Stack order confirmed: Base -> Gasket ->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
    [sentinel_nanopore_reader.scad]
2026-02-01 Update Gasket_Low_Dead_Volume liquid ports to 4mm and deepen cable slot
    - Increased `port_d_laser` from 2.0mm to 4.0mm to match the liquid port size of the rigid plates.
    - Replaced the standard `Cable_Slot_2D` with a custom 12x12mm cutout centered at Y=-25 in `Gasket_Low_Dead_Volume`. This ensures the cable slot cuts deeper into the gasket body (to Y=-19mm) and fully clears the edge, addressing the issue where the previous slot was too shallow.
    - Updated comments to reflect the new dimensions.
    [cartridge.scad]
2026-02-19 Fix Housing_Pump_Lid export crash and update mating geometry
    - Replaced complex `threaded_rod` with simple cylinders in `Housing_Pump_Case` to resolve CGAL errors and timeout.
    - Replaced circular O-ring groove sweep with square profile in `Housing_Pump_Lid` to prevent WASM crash.
    - Updated `Housing_Pump_Lid` top feet recesses from trapezoids to 13.5mm cylinders to mate with Reader Case.
    - Increased `Housing_Pump_Lid` bottom indexing lip height to 5mm for better engagement.
    [housing_pump.scad]
2026-02-20 Revert simplifications and fix Pump Lid feet orientation
    - Reverted `Housing_Pump_Case` fluid ports to use `threaded_rod` (previously simplified to cylinders).
    - Reverted `Housing_Pump_Lid` O-ring groove to use `circle` profile (previously simplified to square).
    - Updated `Housing_Pump_Lid` feet recesses to use a tapered `trapezoid` shape (via `linear_extrude(scale=0.8)`) so the recess is wider at the top and narrower at the bottom, matching the mating feet orientation.
    - Verified that `npm run export` completes successfully (albeit slower) with these complex geometries restored.
    [constants.scad, housing_pump.scad, housing_reader.scad, torque_cap.scad]
2026-10-15 Update Interposer and Amplifier interfaces to 12-pin Guarded Pogo layout
    Modifies `J_POGO1` (the mechanical interface bridging the active amplifier and
    passive flowcell interposer) from a 6-pin linear array to a 12-pin layout.
    This 12-pin architecture surrounds the ultra-high impedance signals (`WS_CIS`
    and `RE_TRANS`) with explicitly driven `GUARD` pins. By flanking these sensitive
    nodes with driven low-impedance guards across the mechanical pogo connection,
    stray surface leakage across the FR4 and mating interfaces is intercepted and
    bootstrapped.
    Changes:
    - Replaced 6-pin target array footprints with `PogoPin_Target_12Pin_Distributed`.
    - Replaced 6-pin spring header footprints with `Pog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
    [Interposer.kicad_pcb, Interposer.kicad_sch]
2026-10-29 Add modular single-pin pogo pin footprints and per-pin placement options
2026-10-29 Batch WebSocket telemetry frames into 1024-sample chunks
    Batch USB stream telemetry frames in scripts/websocket_bridge.py to send 1024-sample binary chunks per WebSocket message by default (16 USB frames).
    Key changes:
    - Adds --batch-frames CLI option defaulting to 16 USB frames (1024 samples = 4104 bytes per message @ ~97.66 Hz).
    - Sets timestamp header in each WebSocket message to the timestamp of the first frame in the batch.
    - Flushes accumulated samples upon stream termination.
    - Updates tests in tests/test_websocket_bridge.py to verify default 1024-sample batching and custom batching.
    - Updates docs/DAQ_STREAMING_SPEC.md.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
2026-10-30 Fix interposer fluid channel routing and update default footprints
    [Interposer.kicad_pcb, Interposer.kicad_sch]
2026-10-30 Move generate_footprint.py to scripts and update KiCad output paths
2026-10-31 Transition Amplifier to discrete pogo pins on F.Cu
    Update Amplifier schematic and PCB to use 12 discrete single-pin
    SMT pogo pins (P1..P12) placed on F.Cu (top layer) alongside active
    components for a single-sided board assembly. Update J_PAD1 to use
    PogoPin_Target_Landing_1Pin_Guarded and align test assertions.
    [Amplifier.kicad_pcb, Amplifier.kicad_sch]
2026-11-04 Anchor Interposer KiCad script paths to repository root
    Update scripts/build_interposer_kicad.py and
    scripts/build_interposer_symbols.py to resolve board and schematic
    asset paths relative to REPO_ROOT rather than current working
    directory. This ensures verify_interposer_pcb() and rebuild_all.py
    succeed when invoked from either repo root or the scripts/ directory.
2026-11-05 added updated analysis and 3D models
    [Amplifier.kicad_pcb, Amplifier.kicad_sch, Interposer.kicad_pcb]
2026-11-07 Save working state: hardware, scripts, simulations, and KiCad design files
    [Amplifier.kicad_pcb, Amplifier.kicad_sch, Interposer.kicad_pcb]
2026-11-07 minor change
    [Amplifier.kicad_pcb]
2026-11-07 fix(pcb): add front and back silkscreen keepouts and suppress silk over bare copper
    [Amplifier.kicad_pcb]
2026-11-08 fix(pcb): clip silkscreen lines outside electrometer bare copper keepout zone
    - Update scripts/generate_footprint.py with clip_segment_outside_box() to clip
    silkscreen lines outside the bare copper and guard keepout envelope [-6.5, 11.9] x [-6.5, 4.0].
    - Move wafer die boundary and WAFER 4x4mm note from silkscreen to Cmts.User.
    - Move flow labels (CIS FLOW, TRANS FLOW) to Cmts.User and adjust text sizes to 0.8mm.
    - Regenerate library footprints and update SYM1 on Amplifier/Amplifier.kicad_pcb.
    - Eliminates all 17 silk_over_copper DRC violations on SYM1.
    [Amplifier.kicad_pcb]
2026-11-08 docs(memory): document KiCad footprint vector clipping behavior with keepout zones
2026-11-09 fix(pcb): sanitize front component silkscreen over bare copper guard window
    - Move component body outlines, polarity markers, and pogo circles (U2, R1, C1, C19, P4, P5, P6, P8, P2, C14) from F.SilkS to F.Fab so no ink is printed over bare copper.
    - Reposition component reference designators (P4, P5, P6, P8, P2, U2, R1, C1, C19) to clear soldermask coordinates outside the keepout window.
    - Set Reference property layer to F.Fab for dense passives (C14, R32).
    - Integrate sanitize_silkscreen_over_guard() into scripts/generate_board_zones.py.
    - Eliminates 100% of silk_over_copper violations on the PCB (from 22 down to 0).
    [Amplifier.kicad_pcb]
2026-11-09 docs(memory): update note on component silkscreen cleanup in guard keepout
2026-11-09 fix(pcb): restore front component silkscreen outside guard keepout and selectively sanitize keepout area
    - Isolate footprint parsing line-by-line to prevent multiline regex overmatching across unrelated components
    - Restore silkscreen on all 59 components outside the electrometer keepout (207 F.SilkS items intact)
    - Selectively relocate or migrate keepout-intersecting silkscreen to F.Fab for the 11 target components (P4, P5, P6, P8, P2, U2, R1, C1, C19, C14, R32)
    - Confirmed 0 silk_over_copper violations in KiCad DRC
    [Amplifier.kicad_pcb]
2026-11-09 chore(renders): update visual diff renders for front silkscreen restoration
